ronaldocordeiro/Audi_A3_TPMS_on_MIB1/(commit log)

2022-01-24 Arduino code added
2023-03-24 Info on circuit added
2023-03-31 Info on circuit building added
